PimeGiano/ai-soc/results/yolov3-tiny_F/detections.png

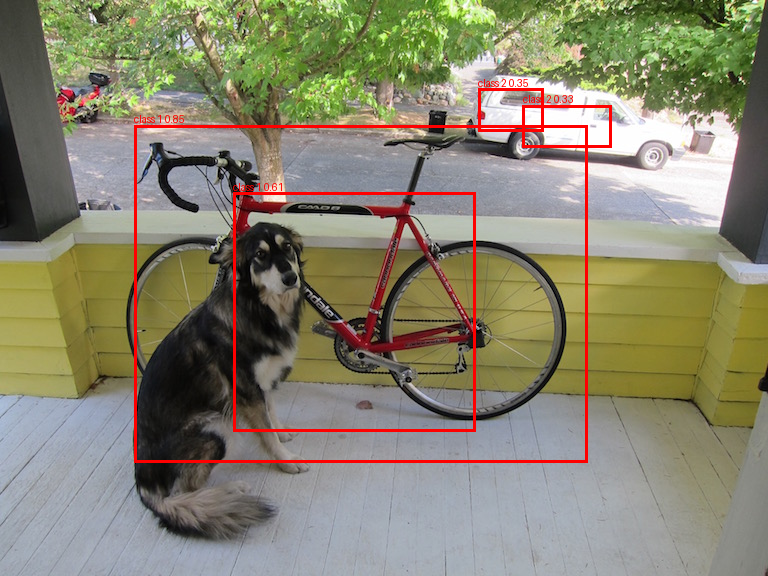
results/yolov3-tiny_F/detections.png
