PimeGiano/ai-soc/docs/team-map.md

# 检测项目分工、实际文件与接口

开始接手前建议按[从零学习指南](learning-guide.md)完成阅读与小实验。

按提供的Excel示例整理的交付见 [分工与框图工作簿](../分工+框图_ai-soc.xlsx)。包含六列模块端口表（152个真实端口）、四人八周分工、17条接口连接、软件与验证契约，以及可单独打印的[系统框图](team-system.svg)和[卷积数据通路](team-datapath.svg)。负责人使用A/B/C/D待填姓名；D明确主责池化硬件与固件/模型联调，C主责MAC/定点并协审池化数值。框图按示例改为框边引脚样式，可在 [diagrams.net源文件](team-interfaces.drawio) 中直接编辑。通过 `python3 scripts/export_team_workbook.py` 可重新导出，原示例文件保留。

主线：**多尺度特征融合与卷积协同加速SoC**。同一RTL运行YOLOv3-tiny / YOLOv4-tiny，研究上采样/拼接中间张量消除。表中A/B/C/D为接手角色，不是四名成员已经完成的贡献记录。

| 角色 | 实际文件（相对项目根目录） | 核心任务与接口 | 接手验收 |
|---|---|---|---|
| A 系统/验证 | rtl/det_soc_top.sv、rtl/native_arbiter.sv、tb/soc.cpp、scripts/build_soc.sh、synth.sh | I1/I2/I3；真实CPU、64MiB仿真主存、字节写、CPU/DMA分类ROI、系统集成/综合 | 快速真实CPU回归、长等待、两模型完整推理 |
| B 融合/调度 | rtl/det_accelerator.sv、spec/registers.json、tb/accelerator.cpp | I2/I3/I4/I5/I8/I9请求；双源坐标、ORDER、跨源通道块、复制散写、X/W/P/O调度、DMA | 随机卷积/融合、容量/范围拒绝、尾字节、读写量与M/F对照 |
| C 计算/数值 | rtl/conv_core.sv、requant.sv、fuse_requant.sv、tb/converter.cpp | I5/I6/I7/I9转换；广播4×4MAC、部分和恢复、输入/输出64位定点舍入/饱和 | 跨Cin块恢复、极值、2048个转换样本、背压与复位 |
| D 池化/模型/软件 | rtl/pool_accelerator.sv、tb/pool.cpp；scripts/model.py、reference.py、export_model.py、evaluate.py；firmware/ | I8及池化CSR/DMA；池化硬件、融合识别、双执行图、BN折叠/量化、CPU软件算子、独立参考、解码/NMS/COCOeval | 同RTL两模型、逐层对拍、CPU框比对、独立100校准/500评价 |

- [当前实际实现](implementation.md)
- [设计框图](architecture.svg) · [DOT源](architecture.dot)
- [已实现接口及字段](interfaces.md)
- [四人八周计划与贡献登记模板](schedule.md)
- [实际测量结果](../results/summary.md)

P RAM调度实际由B模块管理，C核心提供串行restore/result；输入尺度转换是C独立模块，B控制源样本与散写。当前已实现四路分bank和双slot后台预取；B维护存储布局/总线仲裁，C维护MAC与输入量化边界，A维护指令缓存与系统接入。所有分工按真实测试和贡献填写，不能把自动生成内容当作四人既有成果。
