PimeGiano/ai-soc/docs/team-datapath.png

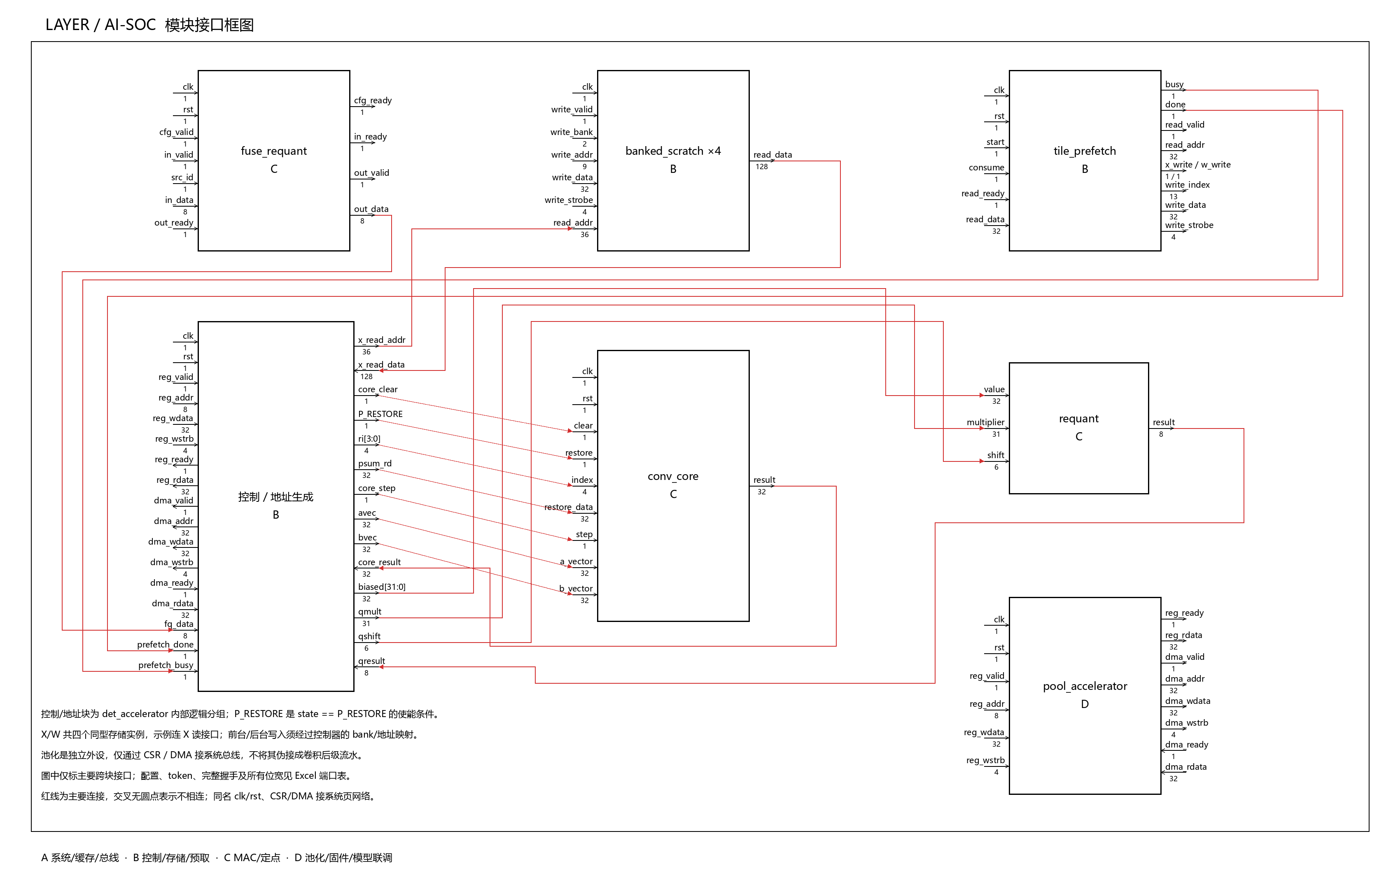
docs/team-datapath.png
