PimeGiano/ai-soc/docs/team-system.png

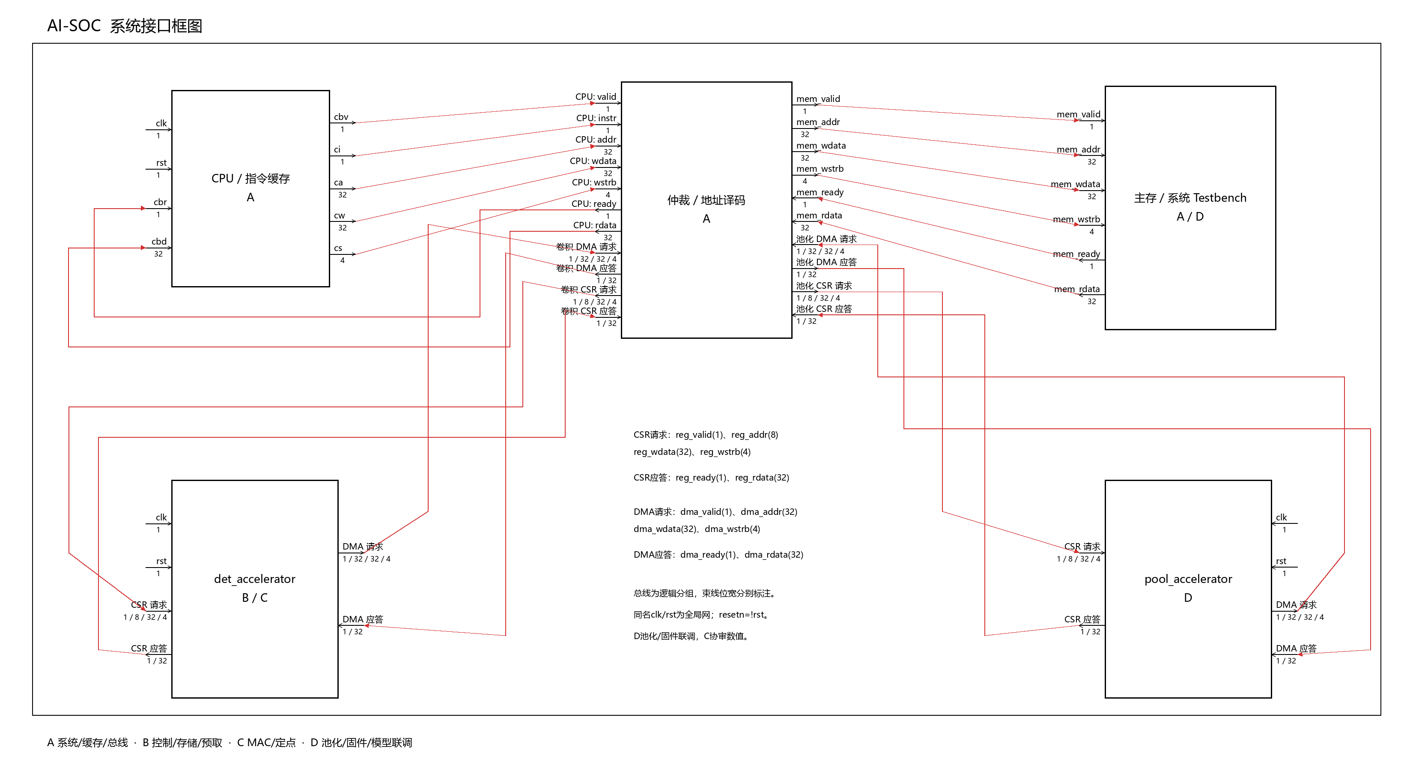
docs/team-system.png
