PimeGiano/ai-soc/分工+框图_ai-soc.xlsx

Sheet: 分模块施工图
多尺度特征融合与卷积协同加速SoC｜分模块施工图 |  |  |  |  |  | 模块接口框图｜框边标端口名、方向与位宽
模块名 | 负责人 | 端口 | 端口方向 | 端口宽度(bit) | 端口功能 | A 系统/缓存/总线｜B 控制/存储/预取｜C MAC/定点｜D 池化硬件/固件联调
det_soc_top rtl/det_soc_top.sv 系统顶层，含CPU/缓存/两级仲裁/卷积及池化外设 | A（待填姓名） | clk | in | 1 | 系统时钟，上升沿更新时序状态
 |  | rst | in | 1 | 高有效同步复位；中断在途任务并清控制/计数，RAM内容不整体清零
 |  | trap | out | 1 | PicoRV32异常/非法执行指示，由系统测试平台检查
 |  | mem_valid | out | 1 | 共享外部主存请求；不含片上MMIO与缓存命中
 |  | mem_addr | out | 32 | 共享外部主存字地址
 |  | mem_wdata | out | 32 | 共享外部主存写数据
 |  | mem_wstrb | out | 4 | 共享外部主存字节选通；0表示读
 |  | mem_ready | in | 1 | 外部主存完成应答
 |  | mem_rdata | in | 32 | 外部主存32位读数据
 |  | mem_dma | out | 1 | 外部完成事务来自卷积或池化DMA，用于ROI分类
 |  | mem_instr | out | 1 | 有意义的外部完成事务中，CPU取指标志
native_arbiter rtl/native_arbiter.sv 两处实例：CPU/卷积仲裁，以及共享出口/池化仲裁 | A（待填姓名） | clk | in | 1 | 系统时钟，上升沿更新时序状态
 |  | rst | in | 1 | 高有效同步复位；中断在途任务并清控制/计数，RAM内容不整体清零
 |  | c_valid | in | 1 | C侧主设备：请求有效，竞争时轮流选择，等待期间锁定所有者
 |  | c_addr | in | 32 | C侧主设备：32位字节地址
 |  | c_wdata | in | 32 | C侧主设备：32位写数据
 |  | c_wstrb | in | 4 | C侧主设备：4位字节写选通；0表示读
 |  | c_ready | out | 1 | C侧主设备：当前事务完成
 |  | c_rdata | out | 32 | C侧主设备：32位读数据
 |  | d_valid | in | 1 | D侧主设备：请求有效，竞争时轮流选择，等待期间锁定所有者
 |  | d_addr | in | 32 | D侧主设备：32位字节地址
 |  | d_wdata | in | 32 | D侧主设备：32位写数据
 |  | d_wstrb | in | 4 | D侧主设备：4位字节写选通；0表示读
 |  | d_ready | out | 1 | D侧主设备：当前事务完成
 |  | d_rdata | out | 32 | D侧主设备：32位读数据
 |  | s_valid | out | 1 | 共享从设备侧：请求有效，竞争时轮流选择，等待期间锁定所有者 | A 系统/缓存/仲裁｜B 融合/存储/预取｜C MAC/定点｜D 池化/固件/模型联调；四人八周共32人周。详见后续工作表。
 |  | s_addr | out | 32 | 共享从设备侧：32位字节地址
 |  | s_wdata | out | 32 | 共享从设备侧：32位写数据
 |  | s_wstrb | out | 4 | 共享从设备侧：4位字节写选通；0表示读
 |  | s_ready | in | 1 | 共享从设备侧：当前事务完成
 |  | s_rdata | in | 32 | 共享从设备侧：32位读数据
instruction_cache rtl/instruction_cache.sv 1KiB直接映射取指缓存，程序区写失效 | A（待填姓名） | clk | in | 1 | 系统时钟，上升沿更新时序状态
 |  | rst | in | 1 | 高有效同步复位；中断在途任务并清控制/计数，RAM内容不整体清零
 |  | cpu_valid | in | 1 | CPU原生请求有效
 |  | cpu_instr | in | 1 | CPU取指标志；仅64KiB程序区取指参与缓存
 |  | cpu_addr | in | 32 | CPU字节地址；标签与索引取对应地址位
 |  | cpu_wstrb | in | 4 | CPU写字节选通；程序区完成写使对应行失效
 |  | cpu_ready | out | 1 | 缓存命中或下游总线完成时应答CPU
 |  | cpu_rdata | out | 32 | 缓存命中数据或旁路总线读数据
 |  | bus_valid | out | 1 | 未命中的请求/非取指请求向仲裁器转发
 |  | bus_ready | in | 1 | 下游CPU侧事务完成
 |  | bus_rdata | in | 32 | 下游CPU侧读数据
det_accelerator rtl/det_accelerator.sv 卷积/融合主控制器、描述符、分块与DMA调度 | B（待填姓名） | clk | in | 1 | 系统时钟，上升沿更新时序状态
 |  | rst | in | 1 | 高有效同步复位；中断在途任务并清控制/计数，RAM内容不整体清零
 |  | reg_valid | in | 1 | MMIO访问有效
 |  | reg_addr | in | 8 | MMIO窗口内字节偏移，32位配置访问须4字节对齐
 |  | reg_wdata | in | 32 | MMIO写数据
 |  | reg_wstrb | in | 4 | MMIO写字节选通；配置写要求1111，0000表示读
 |  | reg_ready | out | 1 | MMIO访问完成握手
 |  | reg_rdata | out | 32 | MMIO读回的配置、状态或计数
 |  | dma_valid | out | 1 | DMA请求有效；等待期间地址、数据和选通保持稳定
 |  | dma_addr | out | 32 | DMA对齐字地址，低两位为0
 |  | dma_wdata | out | 32 | DMA写数据；与wstrb选中的字节对应
 |  | dma_wstrb | out | 4 | DMA字节写使能；0000读、非零写
 |  | dma_ready | in | 1 | DMA本次事务完成，不是仅接收请求
 |  | dma_rdata | in | 32 | DMA完成时的32位读数据
tile_prefetch rtl/tile_prefetch.sv 下一Cin块X/W后台预取，含融合映射与读缓存 | B（待填姓名） | clk | in | 1 | 系统时钟，上升沿更新时序状态
 |  | rst | in | 1 | 高有效同步复位；中断在途任务并清控制/计数，RAM内容不整体清零
 |  | start | in | 1 | 前台开始计算当前块时启动下一Cin块预取
 |  | consume | in | 1 | IC_NEXT已接收完成块，清done；随后交换slot
 |  | fused | in | 1 | 1为双源融合，0为普通NHWC输入
 |  | src | in | 32 | 普通输入主存基址
 |  | weight | in | 32 | OHWI权重主存基址
 |  | src0 | in | 32 | 低分辨率源基址
 |  | src1 | in | 32 | 高分辨率源基址
 |  | width0 | in | 32 | 低路源宽度
 |  | width1 | in | 32 | 高路源宽度
 |  | channels0 | in | 32 | 低路源通道数
 |  | channels1 | in | 32 | 高路源通道数
 |  | order | in | 32 | 0低路在前、1高路在前；由配置检查限制
 |  | multiplier0 | in | 31 | 低路输入尺度转换乘子
 |  | multiplier1 | in | 31 | 高路输入尺度转换乘子
 |  | shift0 | in | 6 | 低路尺度转换右移位数
 |  | shift1 | in | 6 | 高路尺度转换右移位数
 |  | height | in | 32 | 虚拟高分辨率输入H
 |  | width | in | 32 | 虚拟高分辨率输入W
 |  | cin | in | 32 | 虚拟输入总通道数
 |  | cout | in | 32 | 该卷积总输出通道数
 |  | kh | in | 32 | 卷积核高度1或3
 |  | kw | in | 32 | 卷积核宽度，与kh相同
 |  | tic | in | 32 | 输入通道tile容量4/8/16
 |  | toc | in | 32 | 输出通道tile容量4/8/16
 |  | next_ic | in | 32 | 下一输入通道块的起始通道
 |  | oc | in | 32 | 当前输出通道tile起点
 |  | xh | in | 32 | 当前输入tile含halo的高度
 |  | xw | in | 32 | 当前输入tile含halo的宽度
 |  | ytop | in | 32 | 有符号输入tile顶端坐标，可为负表示padding（signed）
 |  | xtop | in | 32 | 有符号输入tile左端坐标，可为负表示padding（signed）
 |  | busy | out | 1 | 预取状态机忙；与前台计算可重叠
 |  | done | out | 1 | 下一块X/W全部填充完成，等待consume
 |  | read_valid | out | 1 | 后台原生DMA读请求有效
 |  | read_addr | out | 32 | 后台32位对齐主存地址
 |  | read_ready | in | 1 | 后台读事务完成，经前后台锁定仲裁得到
 |  | read_data | in | 32 | 后台完成时32位主存读数据
 |  | x_write | out | 1 | 本拍写非活动slot的X
 |  | w_write | out | 1 | 本拍写非活动slot的W
 |  | write_index | out | 13 | 逻辑tile内字节索引0..8191，由控制器转成bank/字地址
 |  | write_data | out | 32 | 整字或重复字节打包写数据
 |  | write_strobe | out | 4 | 本拍有效字节选通
banked_scratch rtl/banked_scratch.sv X/W共4处实例；每实例4×2KiB独立bank | B（待填姓名） | clk | in | 1 | 系统时钟，上升沿更新时序状态
 |  | write_valid | in | 1 | 本拍写有效；每实例仅一个写入口
 |  | write_bank | in | 2 | 选择四个物理bank之一（0..3）
 |  | write_addr | in | 9 | 选中bank内32位字地址0..511
 |  | write_data | in | 32 | 写入的32位数据
 |  | write_strobe | in | 4 | 四个字节独立写使能，保护未选中的字节
 |  | read_addr | in | 36 | 4×9位打包，分别为四个bank的字读地址
 |  | read_data | out | 128 | 4×32位打包，每个bank一个读口；不是一个128位任意地址读口
conv_core rtl/conv_core.sv 4×4 INT8广播MAC，16个INT32累加器 | C（待填姓名） | clk | in | 1 | 系统时钟，上升沿更新时序状态
 |  | rst | in | 1 | 高有效同步复位；中断在途任务并清控制/计数，RAM内容不整体清零
 |  | clear | in | 1 | 同步清零16个累加器，优先于restore/step
 |  | restore | in | 1 | 恢复index对应的一个部分和；该拍不执行step
 |  | index | in | 4 | 16个累加器的串行恢复/读出索引0..15
 |  | restore_data | in | 32 | 有符号INT32部分和恢复数据（signed）
 |  | step | in | 1 | 使能一次4×4外积累加；clear/restore时不执行
 |  | a_vector | in | 32 | 四个INT8激活打包，低字节对应第0行
 |  | b_vector | in | 32 | 四个INT8权重打包，低字节对应第0列
 |  | result | out | 32 | acc[index]，有符号INT32组合读出（signed）
fuse_requant rtl/fuse_requant.sv 前台融合输入定点转换，单样本弹性握手 | C（待填姓名） | clk | in | 1 | 系统时钟，上升沿更新时序状态
 |  | rst | in | 1 | 高有效同步复位；中断在途任务并清控制/计数，RAM内容不整体清零
 |  | cfg_valid | in | 1 | 空闲时提交双源乘移参数
 |  | cfg_ready | out | 1 | 输出槽为空时允许配置
 |  | m0 | in | 31 | 低分辨率源非负31位整数乘子
 |  | m1 | in | 31 | 高分辨率源非负31位整数乘子
 |  | s0 | in | 6 | 低路右移位数，合法范围0..62
 |  | s1 | in | 6 | 高路右移位数，合法范围0..62
 |  | in_valid | in | 1 | 输入样本与源编号有效
 |  | in_ready | out | 1 | 本拍可接受样本；遵循valid/ready
 |  | src_id | in | 1 | 0选低路参数，1选高路参数
 |  | in_data | in | 8 | 有符号INT8输入样本（signed）
 |  | in_token | in | 16 | 随样本透传的16位标签；当前前台控制器固定为0
 |  | out_valid | out | 1 | 转换结果有效，未被接受时保持
 |  | out_ready | in | 1 | 下游可接受转换结果
 |  | out_data | out | 8 | 有符号INT8，半值远离零舍入并饱和至[-127,127]（signed）
 |  | out_token | out | 16 | 与结果对应的16位标签；当前控制器未连接该输出
requant rtl/requant.sv 共享算术模块类型：输出、前台/后台输入转换 | C（待填姓名） | value | in | 32 | 有符号INT32值，内部使用有符号64位乘积（signed）
 |  | multiplier | in | 31 | 非负31位整数乘子
 |  | shift | in | 6 | 右移位数0..62，半值远离零舍入
 |  | result | out | 8 | 有符号INT8结果，饱和到[-127,127]（signed）
pool_accelerator rtl/pool_accelerator.sv 独立2×2最大池化、四通道比较及DMA | D（待填姓名） | clk | in | 1 | 系统时钟，上升沿更新时序状态
 |  | rst | in | 1 | 高有效同步复位；中断在途任务并清控制/计数，RAM内容不整体清零
 |  | reg_valid | in | 1 | MMIO访问有效
 |  | reg_addr | in | 8 | MMIO窗口内字节偏移，32位配置访问须4字节对齐
 |  | reg_wdata | in | 32 | MMIO写数据
 |  | reg_wstrb | in | 4 | MMIO写字节选通；配置写要求1111，0000表示读
 |  | reg_ready | out | 1 | MMIO访问完成握手
 |  | reg_rdata | out | 32 | MMIO读回的配置、状态或计数
 |  | dma_valid | out | 1 | DMA请求有效；等待期间地址、数据和选通保持稳定
 |  | dma_addr | out | 32 | DMA对齐字地址，低两位为0
 |  | dma_wdata | out | 32 | DMA写数据；与wstrb选中的字节对应
 |  | dma_wstrb | out | 4 | DMA字节写使能；0000读、非零写
 |  | dma_ready | in | 1 | DMA本次事务完成，不是仅接收请求
 |  | dma_rdata | in | 32 | DMA完成时的32位读数据
说明：本表完整列出10个自研RTL模块的真实端口；重复实例只列一次并标明实例数。P/O为控制器内部数组，不虚构独立模块端口。第三方PicoRV32接入口见J01。A/B/C/D为待填姓名的计划负责人。

Sheet: 四人八周分工
四人八周分工｜接手、重建与交叉复验计划（非既有贡献声明）
角色 | 方向 | 负责文件 | 主要工作 | 交付/验收 | 计划投入
A（待填姓名） | SoC / 总线 / 缓存 / 系统验证 | det_soc_top、native_arbiter、instruction_cache；tb/soc.cpp、tb/cache.cpp、综合与构建脚本 | CPU接入、两级仲裁、地址译码、取指缓存、ROI计数、系统联调及结构综合 | 读懂PicoRV32接入口；仲裁锁定/缓存失效正确；两模型完整推理与源/构建指纹一致 | 8人周；负责人姓名待填
B（待填姓名） | 融合 / 调度 / 存储 / 预取 | det_accelerator、tile_prefetch、banked_scratch；spec/registers.json、tb/accelerator.cpp | 描述符校验、ORDER和双源映射、四路bank、双slot、DMA锁定、P/O控制与阶段计数 | 0/3/15等待下158任务、6组压力与预取复位；无越界、正确slot切换；消融可复现 | 8人周；负责人姓名待填
C（待填姓名） | MAC / 定点 / 池化数值协审 | conv_core、requant、fuse_requant；tb/converter.cpp；协审tb/pool.cpp | INT8×INT8→INT32、部分和恢复、64位乘移舍入、饱和；协审2×2池化数值与边界 | 2048转换样本；100池化+5非法配置；跨Cin与-128边界逐元素一致；无额外池化RAM | 8人周；负责人姓名待填
D（待填姓名） | 池化硬件 / 固件 / 模型联调 | pool_accelerator、tb/pool.cpp；firmware/、model.py、reference.py、export_model.py、evaluate.py、gen_*.py | 池化硬件与驱动、模型图/量化、融合识别、CPU算子、解码NMS、COCO与独立参考联调 | 两模型M/F逐层与CPU框一致；100校准/500评价不重叠；完整INT8转换/字复制验证 | 8人周；负责人姓名待填
每周并行四个人，每格约一人周；以下共8周×4人=32人周。所有成员须理解本人接口，并交叉审核相邻模块。
周次 | A：系统/验证 | B：调度/搬运 | C：计算/数值 | D：模型/软件 | 共同验收门槛
W1 | 搭建CPU/总线仿真与计数环境，梳理时钟/复位 | 核对描述符、双源ORDER、容量和接口表 | 手算MAC/定点/池化边界，建立参考样例 | 固定模型、权重、输入和量化；跑通导出 | 共同冻结CSR/描述符、方向/位宽与黄金结果
W2 | 复验仲裁锁定与随机等待、建立构建脚本 | 复现普通卷积前台装载/分块/P保存恢复 | 复现conv_core/requant，完成数值单测 | 固件启动/驱动、NumPy INT64独立参考 | 普通卷积逐元素一致；CPU真正执行机器码
W3 | 接通融合路径与系统内存模型，审查范围校验 | 实现源映射、通道边界与2×散写 | 输入转换器弹性握手/复位/背压验证 | M/F计算图、CPU物化与解码/NMS | 同一融合子图M/F逐字节一致
W4 | 指令缓存、冲突替换与程序区写失效 | 四路bank与行旋转、容量回退、DMA打包 | 与B联调连续step/末次排空，审查补零跳过 | 生成短行/stride2/尾通道压力用例 | bank容量/单端口证据、缓存单测、MAC计数通过
W5 | 前后台/三级主设备总线联调与ROI准确性 | 双slot下一Cin块预取，锁定/交换/复位 | 融合后台定点算术与部分和跨块复核 | 建立性能基线与关闭并行取数/预取消融 | 0/3/15等待、预取中复位、无越界与无重复写回
W6 | 接通池化独立CSR/DMA和系统冒烟 | 审查预取/池化与主存竞争及尾部选通 | 协审池化比较/边界，维护MAC与定点验证 | 池化硬件及驱动，100随机+5非法，B0回退与字级转换 | 池化/转换/复制边界对拍；scratch保持40KiB
W7 | 跑两模型完整系统仿真、结构综合与指纹核查 | 统计阶段/冲突/预取等待，分析实际瓶颈 | 复查所有数值和资源声明，定位异常层 | M/F与历史性能表，独立COCO精度评价 | v3/v4全层及检测框一致；精度/周期/流量口径清楚
W8 | 完成系统复验、交付构建/环境说明 | 完成接口/状态机/存储布局文档与框图 | 完成算术/池化模块说明及答辩实验 | 完成报告、学习指南、数据来源与演示 | 四人交叉验收、可复现归档；不虚报FPGA频率/功耗

Sheet: 接口连接表
模块连接与联调责任｜信号方向从源模块看；返回通道反向
接口编号 | 源模块/端口 | 目标模块/端口 | 端口宽度(bit) | 协议/功能 | 双方负责人
J01 | picorv32.mem_* | instruction_cache.cpu_* | valid/instr/ready=1，addr/data=32，wstrb=4 | CPU原生完成握手；第三方CPU仅复用和配置，不改内部RTL | A ↔ A
J02 | instruction_cache.bus_valid；CPU ca/cw/cs | arb.c_* | valid/ready=1，addr/data=32，wstrb=4 | 缓存只拦截命中取指；地址/写数据/选通直接接仲裁器 | A ↔ A
J03 | det_accelerator.dma_* | arb.d_* | valid/ready=1，addr/data=32，wstrb=4 | 卷积前台/后台共享同一个对外DMA主接口 | B ↔ A
J04 | arb.s_* | 地址译码（det_soc_top内部） | valid/ready=1，addr/data=32，wstrb=4 | CPU/卷积组合出口先译码，MMIO在片上完成 | A ↔ A
J05 | 译码0x100001xx | det_accelerator.reg_* | offset=8，wdata/rdata=32，wstrb=4 | 卷积CSR、状态、描述符地址及阶段/预取计数 | A ↔ B
J06 | 译码0x100002xx | pool_accelerator.reg_* | offset=8，wdata/rdata=32，wstrb=4 | 池化SRC/DST/H/W/C/STRIDE/START/STATUS | A ↔ C
J07 | 非MMIO的arb.s_* | pool_arbiter.c_* | valid/ready=1，addr/data=32，wstrb=4 | CPU/卷积外存请求进入外层仲裁器C侧 | A ↔ A
J08 | pool_accelerator.dma_* | pool_arbiter.d_* | valid/ready=1，addr/data=32，wstrb=4 | 池化为第三主设备；未完成事务保持稳定 | C ↔ A
J09 | pool_arbiter.s_* / det_soc_top.mem_* | tb/soc.cpp主存BFM | valid/ready=1，addr/data=32，wstrb=4 | 64KiB程序+64MiB数据为仿真模型；不是真实DDR控制器 | A ↔ A/D
J10 | det_accelerator前后台DMA选择器 | tile_prefetch.read_* | valid/ready=1，addr/data=32 | 后台只读；请求等待时锁定选中方直到完成 | B ↔ B
J11 | det_accelerator / tile_prefetch | slots[0/1].input_store / weight_store | write:1+2+9+32+4；read:36→128 | 共4个banked_scratch实例；每实例四个2KiB bank；非活动slot写、活动slot读 | B ↔ B
J12 | 四bank读数据→bank旋转/冲突检测 | conv_core.a_vector / b_vector / step | 32 / 32 / 1 | 每向量4×INT8；冲突可回退；无冲突每拍完整向量，末次排空 | B ↔ C
J13 | det_accelerator内部psum数组 | conv_core.restore/index/restore_data/result | 1 / 4 / 32 / 32 | P是控制器内1024×INT32数组，不存在独立psum_ram.sv端口 | B ↔ C
J14 | 前台源样本/双源参数 | fuse_requant | 样本8，src_id1，m31×2，s6×2，token16 | 前台转换valid/ready；当前token=0，out_token未接 | B ↔ C
J15 | fuse_requant / tile_prefetch / 输出量化选择 | requant.value/multiplier/shift/result | 32 / 31 / 6 / 8 | 同一算术模块类型的多处实例；无clk，不可虚构ready/valid | B/C ↔ C
J16 | conv_core.result→bias/激活/量化 | det_accelerator内部obuf→DMA | INT32→INT8；O=1024×32 | O为内部数组；对齐四字节写，尾部单字节选通 | C ↔ B
J17 | 固件det_conv / det_pool | 卷积CSR / 池化CSR | 32位MMIO，描述符地址32 | fence保证顺序；轮询完成并检查错误；不把START接受当DONE | D ↔ A/B/C

Sheet: 软件与验证接口
D的软件交付与软硬件契约｜软件项不虚构RTL端口，用文件/格式/调用关系描述
交付项 | 负责人 | 输入/输出 | 数据格式或规模 | 调用/连接对象 | 验收依据
模型导出 | D | cfg/weights/图片 → model.mem | NHWC INT8、OHWI INT8、每通道5×INT32量化参数 | export_model.py → firmware/main.c | 相同RTL执行v3/v4；BN折叠、哈希与量化信息固定
计算图 | D | 图头/操作表 → 解释器 | 图头16×32位=64B；操作记录24×32位=96B | 0x01008000；type1卷积、2池化、3拼接、4切片、5上采样 | 模式2保留CPU卷积/池化；其他模式用硬件支持路径
卷积描述符 | B/D | 主描述符与融合子描述符 | 32×32位=128B；融合16×32位=64B | spec/registers.json → gen_spec.py → C/SV常量 | 范围/重叠/保留位检查；FLAGS.bit1仍保留，双slot自动启用
固件与启动 | D/A | start.S/link.ld/C → firmware.bin | RV32IM，程序窗口64KiB；二进制不是model.mem | build_firmware.sh → picorv32 | 栈/BSS/入口正确；当前固件和RTL指纹与测试构建匹配
池化驱动 | D/C/A | H/W/C/stride、src/dst → det_pool | 2×2、stride1/2；4×INT8或尾字节 | POOL_BASE=0x10000200，独立DMA | 100随机+5非法；真实CPU打包/尾部/B0回退；边界-127
CPU复制/转换 | D | INT8源 → 切片/上采样/拼接 | 对齐32位访问；其他地址与尾部按字节处理 | converted_copy与memcpy语义不同 | 恒等转换-128→-127；普通memcpy保留-128；全INT8域小图对拍
算子独立参考 | D交付，B/C复核 | 张量/参数 → INT64 NumPy期望值 | 不采用RTL调度代码作为参考 | reference.py、gen_vectors.py、gen_stress.py | 151有效+7非法；6压力；0/3/15等待；预取中复位；每写字节范围检查
系统验证 | A主责，D交叉 | model.mem+firmware.bin → 全层结果 | CPU FNV哈希 + 测试平台逐字节比较 | tb/soc.cpp、checks.txt、check_boxes.py | 两个模型M/F各测子图与整网；CPU解码/NMS与NumPy匹配
数值单测 | C主责转换器、D主责池化 | 转换器/池化随机刺激 → 结果 | 2048转换样本、100池化、5非法配置 | tb/converter.cpp、tb/pool.cpp | 舍入、饱和、-128、反压、复位、边界与非法范围
性能/精度 | D主责，A复核 | ROI日志/评价清单 → 报告 | 周期/实际总线字节；100 train校准、500 val评价 | summarize.py、compare_performance.py、evaluate.py | 主机AP不冒充500图RTL；周期比不是板上FPS；M/F单独报告

Sheet: 系统框图
系统框图｜框边端口名、方向与位宽；A/B/C/D为负责人
可缩放矢量图：docs/team-system.svg；同版可编辑源：docs/team-interfaces.drawio；DOT另提供接口拓扑。完整端口见主表。

Sheet: 模块接口框图
模块接口框图｜框边端口名、方向与位宽；A/B/C/D为负责人
可缩放矢量图：docs/team-datapath.svg；同版可编辑源：docs/team-interfaces.drawio；DOT另提供接口拓扑。完整端口见主表。

Sheet: 填写说明
填写与版本说明
项目 | 说明
使用方式 | 主表沿用示例六列：模块名/负责人/端口/方向/位宽/功能；A/B/C/D都有实际RTL模块，其中D负责池化及软硬件联调。右侧是黑白接口框图，框内仅模块名/负责人，框边列端口与位宽；另外两张框图表可单独A3横向打印，主表打印只含A:F，避免框图把端口表压得过小。
负责人 | 将A/B/C/D替换成真实姓名；角色与颜色在所有工作表和框图中一致。示例中的赵甲/钱乙/孙丙/李丁不是本项目已确认成员，不沿用为真实姓名。
方向和位宽 | 从各RTL模块本身观察in/out。脚本解析当前10个自研模块，共152个命名端口，位宽来自声明；signed在功能栏标出。
时钟/复位 | 自研时序模块clk上升沿、rst高有效同步；PicoRV32 resetn=!rst。requant为纯组合，无时钟或握手端口。
实例与内部数组 | banked_scratch实例4处（X/W各两slot），每实例内部4个物理bank；native_arbiter两处。P/O是det_accelerator内部数组，不能照搬示例中的独立psum_ram/pooling_ram端口。
资源口径 | 卷积scratch 40KiB；指令缓存1248B、后台读缓存16B数据+116bit标签/有效位，以及CSR/描述符/累加器等另外统计。池化无额外scratch RAM。
验证范围 | 仿真主存64KiB程序+64MiB数据；结构综合未包含FPGA布局布线或真实DDR。主机500图精度评价不能写成500图RTL验证，周期比不是板上FPS。
参考示例 | 分工+框图_v0_示例.xlsx；保留原文件，不覆盖。模板SHA256：0ce4a2867f8553bef290855113a3aec25f678a9354d6321d907097067c4f1d79
重新导出 | python3 scripts/export_team_workbook.py；调用scripts/team_schematic.py。无需额外Excel Python库；生成PNG需Pillow与中文字体（微软雅黑或Noto CJK）。Excel已嵌入PNG，直接打开即可。表中真实端口从RTL自动读取，负责人和功能说明在导出脚本中维护。
后续扩展 | 更大阵列、真实AXI/DDR与物理时序需要单独设计验证，不在当前框图中画成已完成模块。
