PimeGiano/ai-soc/results/performance.md

# 性能优化前后对比

基线提交：`8bd18c4ed07a2c60051ac5dd46f59def4643721f`。相同输入、量化、分块与仿真总线条件；当前同时包含供数、预取、指令缓存、CPU算子和独立池化硬件优化，速度比是周期比，不是板上FPS。第一轮记录保存在performance_stage1.json。算子汇总仅含151组有效任务，延迟3使用相同种子的事务等待，但事务减少后随机序列与地址对应会改变。

| 场景 | 原始周期 | 第一轮周期 | 当前周期 | 对原始加速 | 对第一轮加速 |
|---|---:|---:|---:|---:|---:|
| 算子合集 delay=0 | 9,946,468 | 5,561,116 | 2,422,815 | 4.105× | 2.295× |
| 算子合集 delay=3 | 10,365,021 | 5,960,773 | 2,823,806 | 3.671× | 2.111× |
| yolov3-tiny M subgraph | 89,664,648 | 42,817,362 | 8,546,396 | 10.492× | 5.010× |
| yolov3-tiny M whole | 487,569,827 | 239,976,915 | 43,187,759 | 11.290× | 5.557× |
| yolov3-tiny F subgraph | 75,971,811 | 32,663,476 | 8,011,888 | 9.482× | 4.077× |
| yolov3-tiny F whole | 473,876,990 | 229,823,029 | 42,653,251 | 11.110× | 5.388× |
| yolov4-tiny M subgraph | 89,662,073 | 42,814,787 | 8,546,396 | 10.491× | 5.010× |
| yolov4-tiny M whole | 705,396,740 | 414,584,720 | 66,329,313 | 10.635× | 6.250× |
| yolov4-tiny F subgraph | 75,971,811 | 32,663,476 | 8,011,888 | 9.482× | 4.077× |
| yolov4-tiny F whole | 691,706,478 | 404,433,409 | 65,794,805 | 10.513× | 6.147× |

## 同源码消融（151组有效任务，delay=0）

| 关闭的机制 | 关闭时周期 | 全部开启周期 | 开启带来的加速 |
|---|---:|---:|---:|
| serial | 2,729,812 | 2,422,815 | 1.127× |
| no_prefetch | 2,847,921 | 2,422,815 | 1.175× |

## 接入池化硬件前后的系统版本

| 场景 | 接入前周期 | 当前周期 | 加速比 |
|---|---:|---:|---:|
| yolov3-tiny M | 91,662,823 | 43,187,759 | 2.122× |
| yolov3-tiny F | 90,438,578 | 42,653,251 | 2.120× |
| yolov4-tiny M | 95,680,736 | 66,329,313 | 1.443× |
| yolov4-tiny F | 94,456,491 | 65,794,805 | 1.436× |

所有有效算子跳过补零MAC，实际计算步数不超过基线，输出字节数保持一致；每组结果逐字节匹配独立参考。完整模型逐层验证并检查CPU检测框。原始基线保存在performance_baseline.json，当前日志和比较结果附SHA256。
