PimeGiano/ai-soc/(commit log)

2026-10-28 Document the fused object detection SoC and reproduction steps
2026-10-28 Implement and verify multi-scale fused object detection SoC
    Publish configurable INT8 convolution and feature fusion RTL, RISC-V firmware, model tools, interfaces and measured M/F results. Remove superseded GEMM/MNIST implementation and design archives. Keep weights, datasets, toolchains and build outputs out of the repository.
    [yolov3-tiny.cfg, yolov4-tiny.cfg]
2026-10-28 Flatten project directories and update all runtime paths
    Remove redundant det and detection directory layers across RTL, firmware, tests, scripts, specs, data, results and docs. Update project-root discovery, include paths, generated metadata, calibration cache fingerprints and documentation links. Rebuild from clean caches and verify quick regression plus both models in M/F modes.
    [yolov3-tiny.cfg, yolov4-tiny.cfg]
2026-10-28 Add a beginner learning guide for the fused detection SoC
    Explain the reading order, host/firmware/testbench separation, convolution and tiling, fusion mapping, integer arithmetic, bus protocol, state machine and model export. Include executable examples, staged exercises, troubleshooting and self-check answers. Link the guide from project entry points.
